Hardware7253/bldc_esc/PCB/esc.kicad_pcb

## KiCad design PCB/esc.kicad_pcb (2026-10-27)

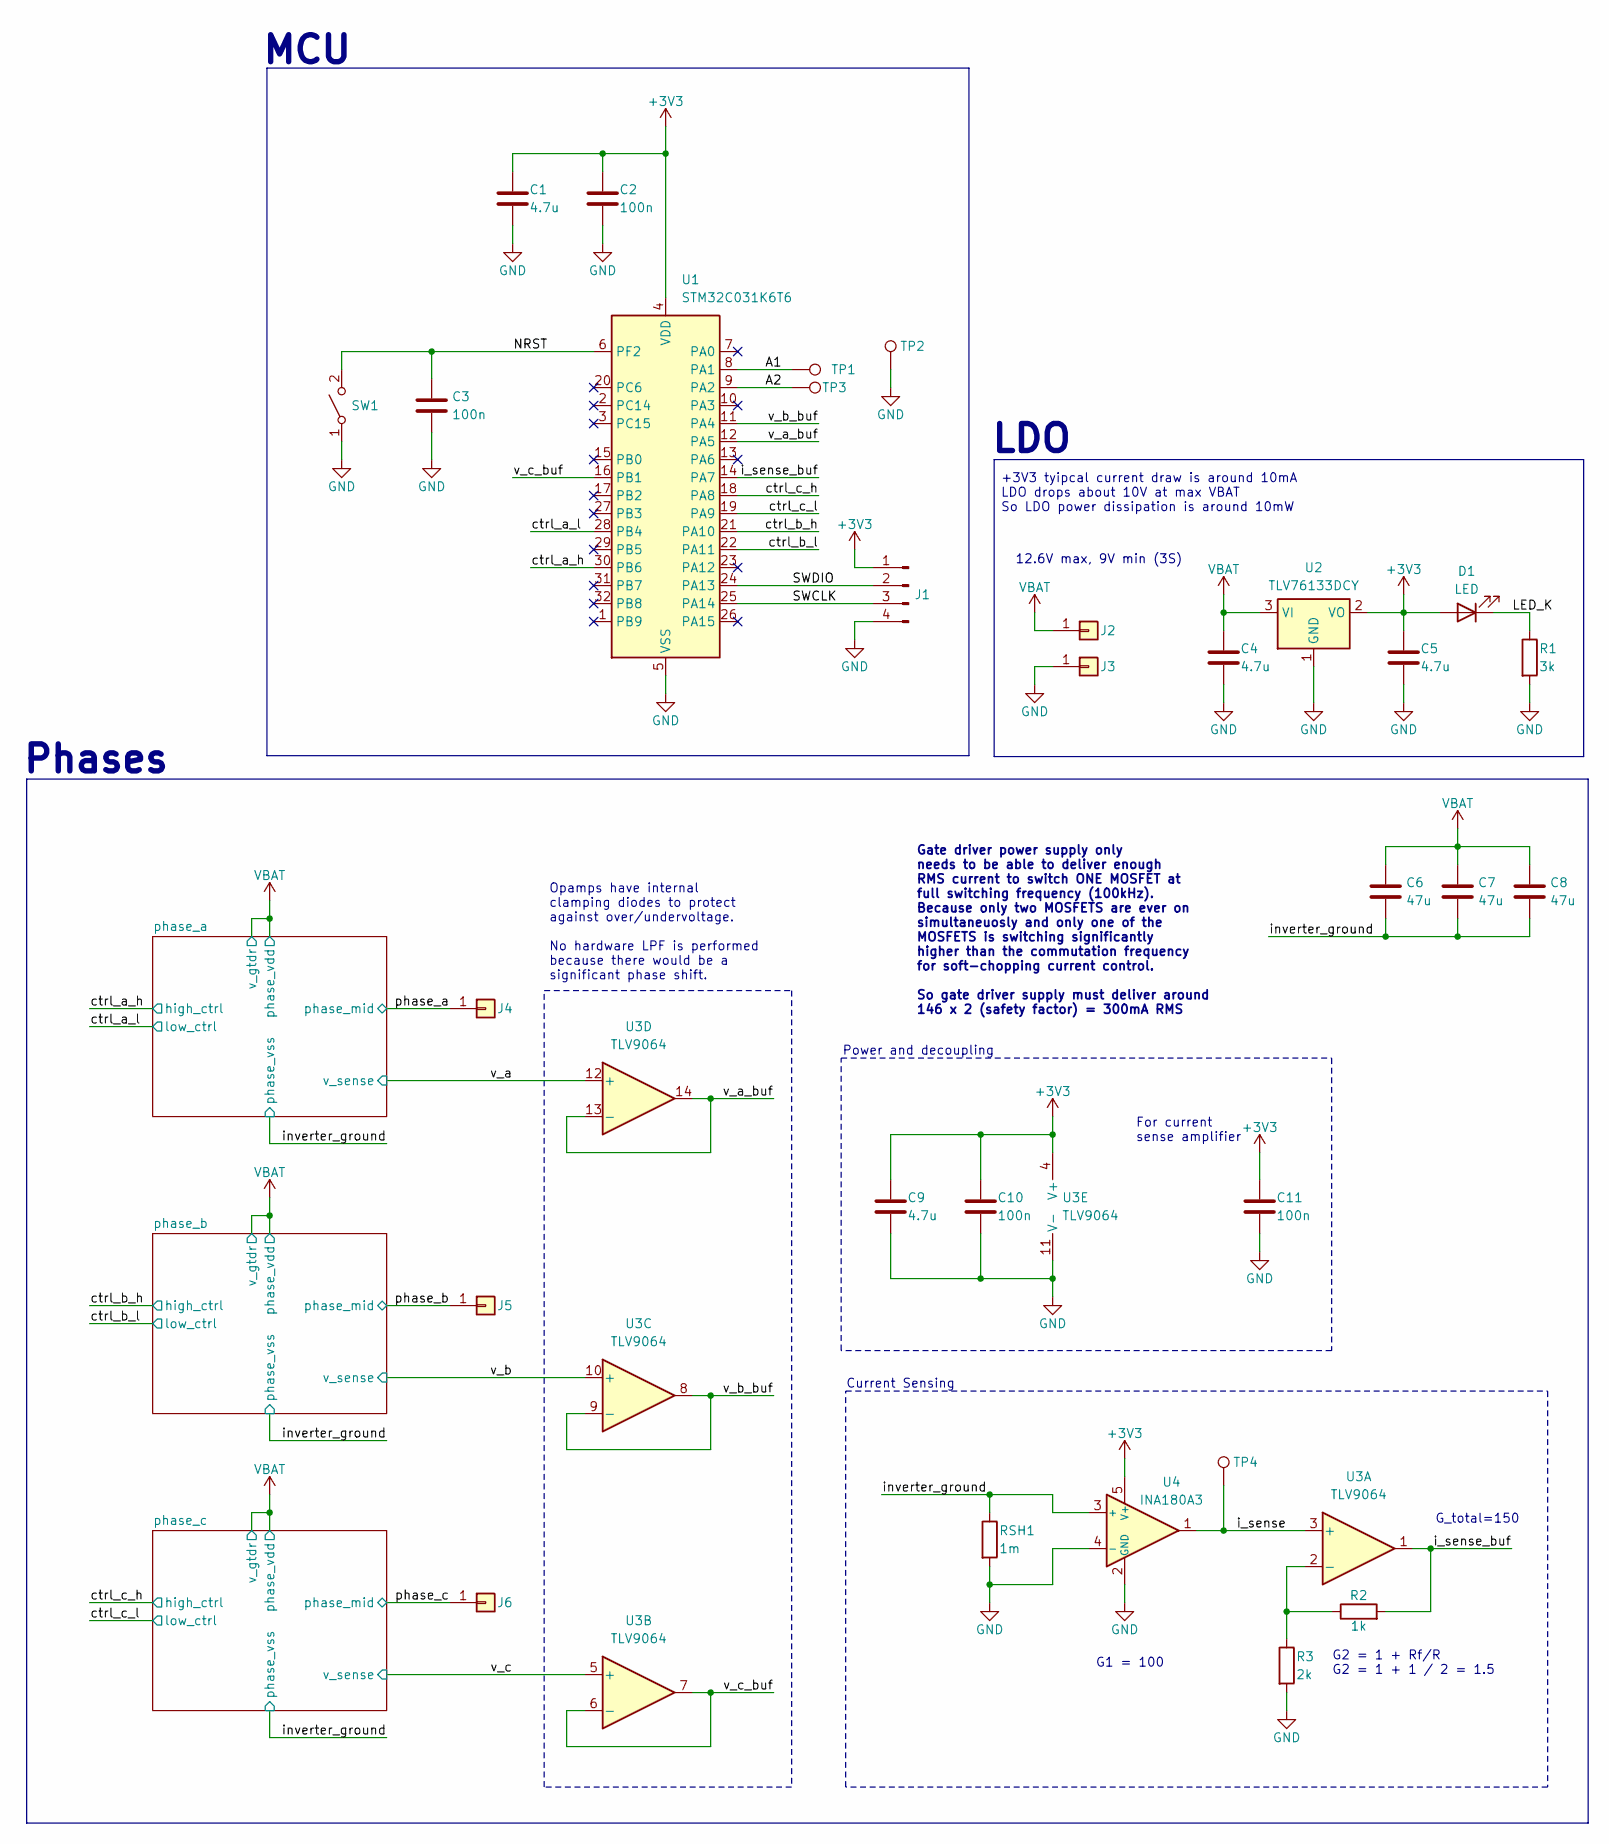
[picture p1: schematic esc.kicad_sch]

Parts:
C1, C4, C5, C9: 4.7u; C_0603_1608Metric; LCSC Part No. C1705
C2, C3, C10, C11: 100n; C_0603_1608Metric; LCSC Part No. C14663
C6, C7, C8: 47u; C_1206_3216Metric; LCSC Part No. C6119972
D1: LED; LED_0603_1608Metric; LCSC Part No. C2286
J1: Conn_01x04_Pin; PinHeader_1x04_P1.27mm_Vertical_SMD_Pin1Right; LCSC Part No. C41375974
J2, J3, J4, J5, J6: Conn_01x01; TestPoint_Pad_2.5x2.5mm
R1: 3k; R_0603_1608Metric; LCSC Part No. C2907033
R2: 1k; R_0603_1608Metric; LCSC Part No. C22548
R3: 2k; R_0603_1608Metric; LCSC Part No. C22975
RSH1: 1m; R_2512_6332Metric; LCSC Part No. C46634444
SW1: SW_SPST; SW_SPST_CK_RS282G05A3; LCSC Part No. C118141
TP1, TP2, TP3, TP4: TestPoint; TestPoint_Pad_D1.5mm
U1: STM32C031K6T6; LQFP-32_7x7mm_P0.8mm; LCSC Part No. C5456169
U2: TLV76133DCY; SOT-223-3_TabPin2; LCSC Part No. C7527500
U3: TLV9064; TSSOP-14_4.4x5mm_P0.65mm; LCSC Part No. C779410
U4: INA180A3; SOT-23-5; LCSC Part No. C2877844

Connections:
+3V3: C1.1, C2.1, C5.1, C9.1, C10.1, C11.1, D1.2 (A), J1.1, U1.4 (VDD), U2.2 (VO), U3.4 (V+), U4.5 (V+)
/A1: TP1.1 (1_1), U1.8 (PA1)
/A2: TP3.1 (1_1), U1.9 (PA2)
/LED_K: D1.1 (K), R1.1
/NRST: C3.1, SW1.2 (B), U1.6 (PF2)
/SWCLK: J1.3, U1.25 (PA14)
/SWDIO: J1.2, U1.24 (PA13)
/ctrl_a_h: U1.30 (PB6); also elsewhere on the board
/ctrl_a_l: U1.28 (PB4); also elsewhere on the board
/ctrl_b_h: U1.21 (PA10); also elsewhere on the board
/ctrl_b_l: U1.22 (PA11); also elsewhere on the board
/ctrl_c_h: U1.18 (PA8); also elsewhere on the board
/ctrl_c_l: U1.19 (PA9); also elsewhere on the board
/i_sense: TP4.1 (1_1), U3.3 (+), U4.1
/i_sense_buf: R2.2, U1.14 (PA7), U3.1
/inverter_ground: C6.2, C7.2, C8.2, RSH1.1, U4.3 (+); also elsewhere on the board
/phase_a: J4.1 (Pin_1_1); also elsewhere on the board
/phase_b: J5.1 (Pin_1_1); also elsewhere on the board
/phase_c: J6.1 (Pin_1_1); also elsewhere on the board
/v_a: U3.12 (+); also elsewhere on the board
/v_a_buf: U1.12 (PA5), U3.13 (-), U3.14
/v_b: U3.10 (+); also elsewhere on the board
/v_b_buf: U1.11 (PA4), U3.8, U3.9 (-)
/v_c: U3.5 (+); also elsewhere on the board
/v_c_buf: U1.16 (PB1), U3.6 (-), U3.7
GND: C1.2, C2.2, C3.2, C4.2, C5.2, C9.2, C10.2, C11.2, J1.4, J3.1 (Pin_1_1), R1.2, R3.2, RSH1.2, SW1.1 (A), TP2.1 (1_1), U1.5 (VSS), U2.1 (GND), U3.11 (V-), U4.2 (GND), U4.4 (-); also elsewhere on the board
unnamed: R2.1, R3.1, U3.2 (-)
VBAT: C4.1, C6.1, C7.1, C8.1, J2.1 (Pin_1_1), U2.3 (VI); also elsewhere on the board

Notes on the sheet:
Current Sensing
G2 = 1 + Rf/R G2 = 1 + 1 / 2 = 1.5
MCU
For current sense amplifier
+3V3 tyipcal current draw is around 10mA LDO drops about 10V at max VBAT So LDO power dissipation is around 10mW
LDO
G1 = 100
G_total=150
Phases
Gate driver power supply only needs to be able to deliver enough RMS current to switch ONE MOSFET at full switching frequency (100kHz). Because only two MOSFETS are ever on simultaneuosly and only one of the MOSFETS is switching significantly higher than the commutation frequency for soft-chopping 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
12.6V max, 9V min (3S)
Opamps have internal clamping diodes to protect against over/undervoltage. No hardware LPF is performed because there would be a significant phase shift.
Power and decoupling

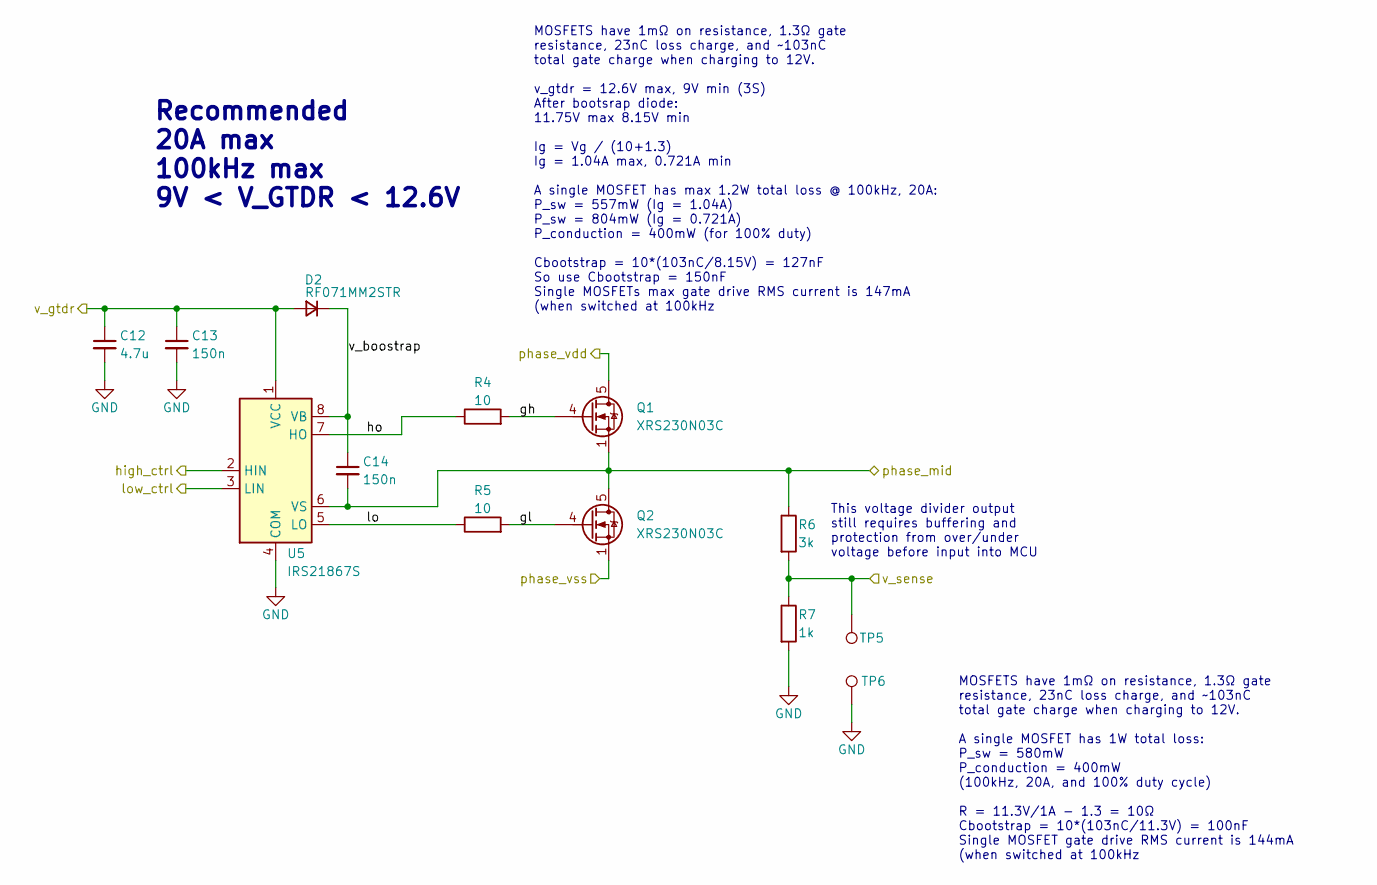
[picture p2: schematic phase.kicad_sch]

Parts:
C12: 4.7u; C_0603_1608Metric; LCSC Part No. C1705
C13, C14: 150n; C_0603_1608Metric; LCSC Part No. C513735
D2: RF071MM2STR; D_SOD-123; LCSC Part No. C253520
Q1, Q2: XRS230N03C; PQFN-8-EP_6x5mm_P1.27mm_Generic; LCSC Part No. C53069585
R4, R5: 10; R_0603_1608Metric; LCSC Part No. C844919
R6: 3k; R_0603_1608Metric; LCSC Part No. C2907033
R7: 1k; R_0603_1608Metric; LCSC Part No. C22548
TP5, TP6: TestPoint; TestPoint_Pad_D1.5mm
U5: IRS21867S; SOIC-8_3.9x4.9mm_P1.27mm; LCSC Part No. C20623204

Connections:
/ctrl_a_h: U5.2 (HIN); also elsewhere on the board
/ctrl_a_l: U5.3 (LIN); also elsewhere on the board
/inverter_ground: Q2.1 (S), Q2.2 (S), Q2.3 (S); also elsewhere on the board
/phase_a: C14.2, Q1.1 (S), Q1.2 (S), Q1.3 (S), Q2.5 (D), R6.1, U5.6 (VS); also elsewhere on the board
/phase_a/gh: Q1.4 (G), R4.2
/phase_a/gl: Q2.4 (G), R5.2
/phase_a/ho: R4.1, U5.7 (HO)
/phase_a/lo: R5.1, U5.5 (LO)
/phase_a/v_boostrap: C14.1, D2.1 (K), U5.8 (VB)
/v_a: R6.2, R7.1, TP5.1 (1_1); also elsewhere on the board
GND: C12.2, C13.2, R7.2, TP6.1 (1_1), U5.4 (COM); also elsewhere on the board
VBAT: C12.1, C13.1, D2.2 (A), Q1.5 (D), U5.1 (VCC); also elsewhere on the board

Parts of its further copies:
C15, C18: 4.7u; C_0603_1608Metric; LCSC Part No. C1705
C16, C17, C19, C20: 150n; C_0603_1608Metric; LCSC Part No. C513735
D3, D4: RF071MM2STR; D_SOD-123; LCSC Part No. C253520
Q3, Q4, Q5, Q6: XRS230N03C; PQFN-8-EP_6x5mm_P1.27mm_Generic; LCSC Part No. C53069585
R8, R9, R12, R13: 10; R_0603_1608Metric; LCSC Part No. C844919
R10, R14: 3k; R_0603_1608Metric; LCSC Part No. C2907033
R11, R15: 1k; R_0603_1608Metric; LCSC Part No. C22548
TP7, TP8, TP9, TP10: TestPoint; TestPoint_Pad_D1.5mm
U6, U7: IRS21867S; SOIC-8_3.9x4.9mm_P1.27mm; LCSC Part No. C20623204

Connections of its further copies:
/ctrl_b_h: U6.2 (HIN); also elsewhere on the board
/ctrl_b_l: U6.3 (LIN); also elsewhere on the board
/ctrl_c_h: U7.2 (HIN); also elsewhere on the board
/ctrl_c_l: U7.3 (LIN); also elsewhere on the board
/inverter_ground: Q4.1 (S), Q4.2 (S), Q4.3 (S), Q6.1 (S), Q6.2 (S), Q6.3 (S); also elsewhere on the board
/phase_b: C17.2, Q3.1 (S), Q3.2 (S), Q3.3 (S), Q4.5 (D), R10.1, U6.6 (VS); also elsewhere on the board
/phase_b/gh: Q3.4 (G), R8.2
/phase_b/gl: Q4.4 (G), R9.2
/phase_b/ho: R8.1, U6.7 (HO)
/phase_b/lo: R9.1, U6.5 (LO)
/phase_b/v_boostrap: C17.1, D3.1 (K), U6.8 (VB)
/phase_c: C20.2, Q5.1 (S), Q5.2 (S), Q5.3 (S), Q6.5 (D), R14.1, U7.6 (VS); also elsewhere on the board
/phase_c/gh: Q5.4 (G), R12.2
/phase_c/gl: Q6.4 (G), R13.2
/phase_c/ho: R12.1, U7.7 (HO)
/phase_c/lo: R13.1, U7.5 (LO)
/phase_c/v_boostrap: C20.1, D4.1 (K), U7.8 (VB)
/v_b: R10.2, R11.1, TP7.1 (1_1); also elsewhere on the board
/v_c: R14.2, R15.1, TP9.1 (1_1); also elsewhere on the board
GND: C15.2, C16.2, C18.2, C19.2, R11.2, R15.2, TP8.1 (1_1), TP10.1 (1_1), U6.4 (COM), U7.4 (COM); also elsewhere on the board
VBAT: C15.1, C16.1, C18.1, C19.1, D3.2 (A), D4.2 (A), Q3.5 (D), Q5.5 (D), U6.1 (VCC), U7.1 (VCC); also elsewhere on the board

Notes on the sheet:
Recommended 20A max 100kHz max 9V < V_GTDR < 12.6V
This voltage divider output still requires buffering and protection from over/under voltage before input into MCU
MOSFETS have 1mΩ on resistance, 1.3Ω gate resistance, 23nC loss charge, and ~103nC total gate charge when charging to 12V. v_gtdr = 12.6V max, 9V min (3S) After bootsrap diode: 11.75V max 8.15V min Ig = Vg / (10+1.3) Ig = 1.04A max, 0.721A min A single MOSFET has max 1.2W total loss @ 100kHz, 20A: 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
MOSFETS have 1mΩ on resistance, 1.3Ω gate resistance, 23nC loss charge, and ~103nC total gate charge when charging to 12V. A single MOSFET has 1W total loss: P_sw = 580mW P_conduction = 400mW (100kHz, 20A, and 100% duty cycle) R = 11.3V/1A - 1.3 = 10Ω Cbootstrap = 10*(103nC/11.3V) = 100nF Single MO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

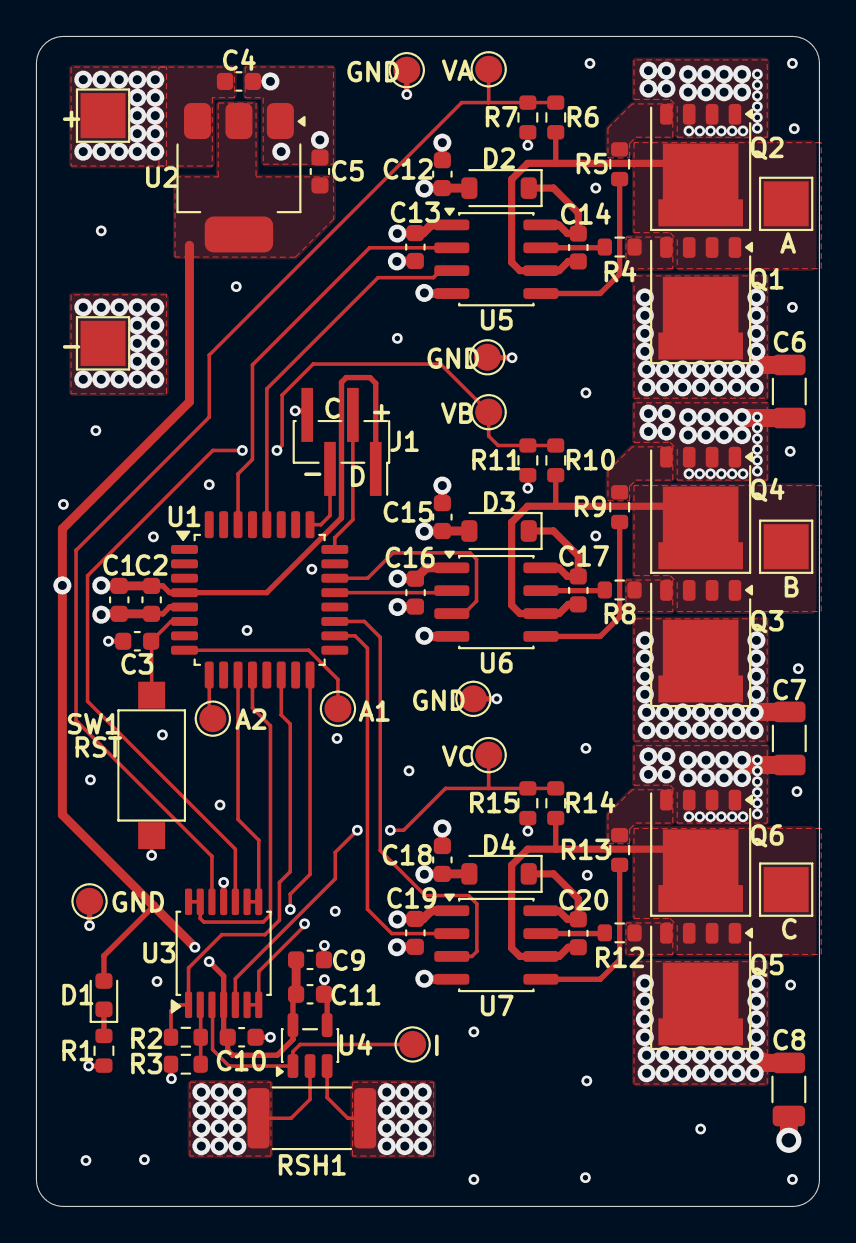
[picture p3: board esc.kicad_pcb from above]

Board: 4 copper layers, 43.5 x 65.0 mm, 70 parts (0 on the bottom side), 43 nets.
