Hardware7253/bldc_esc/(commit log)

2026-09-18 Init commit
    [esc.csv, esc.kicad_pcb, esc.kicad_sch, phase.kicad_sch]
2026-09-28 Added software template
    [esc.csv, esc.kicad_pcb, esc.kicad_sch, phase.kicad_sch]
2026-10-02 Swapped opamp
    Desgin now specifies an opamp with rail-to-rail input.
    [esc.kicad_pcb, esc.kicad_sch]
2026-10-03 Added code for initialising gate drive pins
    Currently the code initialises all pins and starts the PWM on all
    high-side control pins. This is for testing purposes only, it
    would destroy the board if the MOSFETs were populated and the power
    supply was connected.
2026-10-05 Test commutation works
    There is now a function to switch commutation steps with high-side PWM
    (soft-chopping control). The gate drive waveforms look correct but
    hasn't been tested with full inverter populated.
    [esc.kicad_sch, phase.kicad_sch]
2026-10-23 Motor spin-up works
2026-10-23 Switched gate driving PWM to one timer
    One timer is now used so the last OC channel can be used to trigger ADC
    reads on the phase voltages. In theory, haven't implemented yet.
2026-10-24 Added code for ADC reads
    Commiting before switching off double buffering and adding BEMF zero crossing
    detection
2026-10-27 Added template for zero crossing detection
    Done some zero crossing detection in a sample_raw.c interrupt callback.
    Interrupt fires to regularly so PWM frequency had to be reduced so other
    stuff could run. Currently there's a bug where the sample buffer is
    always reading {0, 0, 4095, 0}.
